marthoc/GarHAge/(threads)

Thread 2 (2017-08-29):

Upcoming Feature: Support for two garage door openers

marthoc, 2017-08-29:
Support will be added in the near future to control two garage door openers via one ESP8266 board.

marthoc, 2017-08-31:
Support has been added but code is currently untested; checkout the "two_doors" branch to test and please provide feedback.

marthoc, 2017-09-05:
Suppprt added in v1.0.0!

Closed 2017-09-05.

Thread 8 (2017-11-09):

Unable to publish to broker from other clients

bigalboyo, 2017-11-09:
Hi,
I've just setup and run this project but now only the ESP8266 can publish to the broker with its open or closed state.  Nothing else can publish anything else to the broker.  Even from the command line on the Pi running the broker, I can't publish anything.  Which also means I can't publish anything to trigger the relay.  Its like the program has taken complete control of the broker.  Any ideas why that might be?

Cheers

marthoc, 2017-11-09:
I can’t see how a client could possibly block other clients from connecting to or publishing to a broker. Can you give me more details about your setup (really just the broker and how it’s set up) so that I can try to replicate and help you debug?

One thing I’m wondering is if you have specified the same client ID on each device... that would create collisions and constant disconnects/reconnects from and to the broker by the late-joining client that could look like one client was dominating. Client IDs need to be unique.

bigalboyo, 2017-11-13:
Cheers for the response; I realise it is a long shot to put this code as the cause but everything stopped working the moment I ran it for the first time so logically, it got the blame.
As it happens, I ended up having to removed and reinstall mosquitto on the Pi to get the broker running properly again. I've now written my own version of this and everything is going fine. Will chalk it up to experience. cheers

marthoc, 2017-11-13:
Sorry to hear about your experience and that you couldn’t get GarHAge running. Thanks for reporting this, and if you have any more details so that I can examine the code please let me know.

Closed 2017-11-13.

Thread 10 (2017-12-13):

Feature request

harfordhawk, 2017-12-13:
I love this code and it works great, but I want to use it to attach nodemcu to existing wired alarm panel.  It works great for monitoring 2 'doors', and I really just want to be able to adjust code to use as many pins on the nodemcu as available and just get status messages from each, similar to the way it does now..
I am not so good at adjusting code to do that.. can you give me example code that just monitors those pins?  thanks so much

marthoc, 2017-12-14:
This would be easy to implement and in fact I’ve been thinking of releasing a new project that does exactly this - NodeMCU has 8 or 10 (I think) inputs that can be used for this, so could probably retrofit an existing alarm system with a few NodeMCUs pretty easily. Glad to know I’m not the only one that’s been thinking about it. If you give me a few days or so, I’ll get back to you with some code to test. Sound good?

marthoc, 2017-12-14:
Quick question - on your existing alarm system, do the wired sensors each have just two wires that connect to the existing controller?

harfordhawk, 2017-12-14:
thank you!  I hooked up to the door 1 and 2 with current code and it works
pretty well! Great way to retrofit old alarm system that we really don't
use!

On Thu, Dec 14, 2017 at 11:27 AM, Mark Coombes <notifications@github.com>
wrote:

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

harfordhawk, 2017-12-14:
well I am mostly interested in the simple door / window sensors so yeah,
just simple magnetic switches 2 wires,,  I ran a common from each to a
ground on board then one each to d5 and d6

On Thu, Dec 14, 2017 at 11:35 AM, Mark Coombes <notifications@github.com>
wrote:

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

harfordhawk, 2017-12-14:
by the way, I am trying to use it as a mqtt binary sensor... I am getting
some slow to no responses in that mode, but not sure if it's just me or what

On Thu, Dec 14, 2017 at 11:38 AM, mack goodman <mackgoodman@gmail.com>
wrote:

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

marthoc, 2017-12-14:
Hmm... you shouldn’t be getting “slow to no” responses; my experience is that the door state changes are reported virtually instantly. One way to start tracking down the cause is to connect the NodeMCU to your computer via USB (and thereby powering it over USB) and watching the serial monitor as you unplug one of the door sensor wires (simulating an open/close). The state change _should_ be instantly reported on the serial monitor. If you can run mosquitto_sub in a different window at the same time with this command:
`mosquitto_sub -h your.broker.ip.address -t "#" -v`
...you should see an MQTT message arrive at the broker instantly.

marthoc, 2017-12-14:
Maybe also post your configuration.yaml entry for the binary sensor (unless you’re just using what I suggest in README.md).

marthoc, 2017-12-15:
@harfordhawk I just added something for you to test: https://github.com/marthoc/EntrHAnce/releases. Please do and let me know how it goes! I've only verified that it compiles, but I haven't tested it at all yet myself. Please raise any issues on the EntrHAnce page, not here.

Closing this issue.

harfordhawk, 2017-12-15:
thanks! I will let you know when I test it out

On Fri, Dec 15, 2017 at 12:14 AM, Mark Coombes <notifications@github.com>
wrote:

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

harfordhawk, 2017-12-15:
been testing it and it loads fine .  I see the publishing on the serial
monitor
Acouple of things...

1. it seems that I need about 5 seconds between open and close to be
consistent. otherwise it sometimes does not toggle.

2. I can't find what the name of the topic is, at least it doesn't publish
in HA

here is my config

binary_sensor 2:
  - platform: mqtt
    name: "test Door"
    state_topic: "entry/1/status"

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

marthoc, 2017-12-15:
The info is in README.md of the dev branch, sorry. The topic is entry/pin# (so entry/1, etc.). You’ll also need to change the on and off payloads to open and closed.

harfordhawk, 2017-12-15:
okay, sorry I did not read that... seems to be working except the response
is sometimes incorrect when fast switching.  that may be just a function of
timing and asking too much from the mqtt ??  anyway thank you very much for
this code!

On Fri, Dec 15, 2017 at 9:37 AM, Mark Coombes <notifications@github.com>
wrote:

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

marthoc, 2017-12-15:
I think it’s related to the way I’m denouncing the switch inputs. I’ll test today and see if I can’t tweak it.

marthoc, 2017-12-15:
Also - what MQTT broker are you using? If it’s the embedded broker, you might want to test with mosquitto to rule that out.

harfordhawk, 2017-12-15:
i am running mosquitto on the Rpi.. seems to work fine for some other
sensors I have.

Just a thought.. maybe there is a way to put a redundancy in to check
status of pins?  I don't know anything about that but just thinking

On Fri, Dec 15, 2017 at 10:05 AM, Mark Coombes <notifications@github.com>
wrote:

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

harfordhawk, 2017-12-15:
i have noticed with the garage code that if the door is opening and shut
quickly it sometimes gets lost in the updates, then 30sec to a min later it
reports correctly, usually.

On Fri, Dec 15, 2017 at 10:08 AM, mack goodman <mackgoodman@gmail.com>
wrote:

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

marthoc, 2017-12-15:
I think it’s my debounce code. Essentially, when an input changes state (either high to low or vice versa, meaning a door has opened or closed), the code says, take that as the new state and don’t accept any new state changes for 2 seconds (given that reed switches are very bouncy, when they change state they may open and close several times). This prevents the broker from getting several open/closed/open/closed/open messages. So with the garage code, which I’ve reused here, if you open a door and then close it right away, it’s not going to pick that up until the debounce time has passed and the next time through the loop when the input is read again.

But it should be on the order of a few seconds delay in the HA frontend, not 30s to a minute.

As to redundancy, the inputs are supposed to be read on each loop through the code, which should be happening many many times per second. So if there’s a different state, the code should be picking that up very quickly and reporting the change.

I will investigate more and see if I can replicate this, and maybe change the debounce code since this is an issue that affects GarHAge as well.

harfordhawk, 2017-12-15:
could just be my HA code that is working too hard or not efficiently.. I
got a lot of stuff reporting! haha

On Fri, Dec 15, 2017 at 10:33 AM, Mark Coombes <notifications@github.com>
wrote:

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

marthoc, 2017-12-15:
That could be it, honestly. Code in HA runs asynchronous meaning it gets scheduled for execution, and the Pi only has so many resources...

marthoc, 2017-12-15:
OK so I had a chance to wire up my test unit. I'm not seeing any of the delays that you are with updating the state. Really the best way to check what part of your automation flow is responsible for the delay is to have the serial monitor open (and the NodeMCU connected to your computer via USB obviously), and also have a mosquitto_sub window open to watch for incoming messages at the broker.

When I change an input state (I've just wired the inputs to buttons I can push to pull the pin low), there's an instant message on the serial monitor and at the broker I'm watching via mosquitto_sub. So I think that your problem is either a faulty NodeMCU, some network latency, or latency introduced by running Home Assistant on the Raspberry Pi. My HA is set up on an Intel NUC so there's no concern about processing power there.

If you don't mind testing with the serial monitor and mosquitto_sub to help me verify that the latency is introduced outside of my code, I would appreciate it!

One snag I noticed is that D8 wasn't reacting properly; a bit of research revealed that you can't enable the internal pullup resistor on D8, so it can't be used for our purposes. That leaves 7 usable inputs per NodeMCU, which isn't bad - most existing alarm systems in sane-sided houses could probably be retrofitted with 2 or 3 NodeMCU's, I'd guess, which is still a pretty cheap way to do it.

Thanks for your help with this! Any other questions or comments please let me know.

harfordhawk, 2017-12-15:
I did what you said and it seems to be working properly... I think my lag
be associated with either overtaxed rpi or possibly flaky wifi in the area
where the nodemcu is... thanks for your code again!

On Fri, Dec 15, 2017 at 2:28 PM, Mark Coombes <notifications@github.com>
wrote:

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

bradcurtis, 2018-02-01:
Very cool,

I have the NodeMCU as well.  I updated the code to include a temperature/humidity and motion sensors.

Closed 2017-12-15.

Thread 11 (2018-01-27):

Can't compile in Arduino 1.8.5

mattie47, 2018-01-27:
When I try to compile for esp8266, I get:

```
exit status 1
invalid conversion from 'const char*' to 'const uint8_t* {aka const unsigned char*}' [-fpermissive]
```

config.h:
```
/*
 * GarHAge
 * a Home-Automation-friendly ESP8266-based MQTT Garage Door Controller
 * Licensed under the MIT License, Copyright (c) 2017 marthoc
 *
 * User-configurable Parameters
*/

// Wifi Parameters

#define WIFI_SSID "wifi ssid"
#define WIFI_PASSWORD "password"

// Static IP Parameters

#define STATIC_IP false
#define IP 192,168,1,100
#define GATEWAY 192,168,1,1
#define SUBNET 255,255,255,0

// MQTT Parameters

#define MQTT_BROKER "192.168.1.60"
#define MQTT_CLIENTID "GarHAge"
#define MQTT_USERNAME "asdf"
#define MQTT_PASSWORD "asdf"

// Relay Parameters

#define ACTIVE_HIGH_RELAY true

// Door 1 Parameters

#define DOOR1_ALIAS "Door 1"
#define MQTT_DOOR1_ACTION_TOPIC "garage/door/1/action"
#define MQTT_DOOR1_STATUS_TOPIC "garage/door/1/status"
#define DOOR1_OPEN_PIN D2
#define DOOR1_CLOSE_PIN D2
#define DOOR1_STATUS_PIN D5
#define DOOR1_STATUS_SWITCH_LOGIC "NO"

// Door 2 Parameters

#define DOOR2_ENABLED false
#define DOOR2_ALIAS "Door 2"
#define MQTT_DOOR2_ACTION_TOPIC "garage/door/2/action"
#define MQTT_DOOR2_STATUS_TOPIC "garage/door/2/status"
#define DOOR2_OPEN_PIN D1
#define DOOR2_CLOSE_PIN D1
#define DOOR2_STATUS_PIN D6
#define DOOR2_STATUS_SWITCH_LOGIC "NO"
```

Any idea on what I need to do to get this running? :-)

Kharte55, 2018-01-28:
Did you change anything but the config file e.g the firmware file

marthoc, 2018-01-28:
@mattie47 There must be more debug output that gets printed when the compile fails. I need to know which variable it’s complaining about.

mattie47, 2018-01-28:
@marthoc  I'll try again when I'm home from work re. more debug.

>I’m also assuming your wifi SSID doesn’t have a space in it in real life?

It does. I did wonder if this may cause a problem..

marthoc, 2018-01-28:
Well the easy way to test is to remove the space and try again to compile. If it works, there’s your problem. I have to double check but I don’t think the ESP8266WiFi library supports SSIDs with spaces.

marthoc, 2018-01-31:
Any update on this @mattie47? I’m planning a new release in the next week or so and if this is actually a bug I’d like to squash it before then.

walthowd, 2018-01-31:
FWIW, it compiles fine for me a with a space in the SSID. Arduino IDE 1.8.5, esp8266 2.4.0

marthoc, 2018-01-31:
I couldn’t replicate either, that’s why I’d like the full compile output.

mattie47, 2018-01-31:
Hey,

Sorry- life’s been busy. I’ll make it a priority today to try again this evening and post all relevant information.

Thanks,

Matt

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

mattie47, 2018-02-01:
Please see: https://pastebin.com/WJShtYNC

Removing the space in the ssid doesn't change the output.

marthoc, 2018-02-01:
Can you go into the Library Manager in Arduino IDE and tell me what version of PubSubClient you’re on? The call signatures and methods it’s complaining about are certainly in the version I developed against. Maybe you’re on an old version of PSC?

For an example, take one of the first problems it’s compaining of - that the code is trying to cast const char to const unsigned char in publish(); the current API docs clearly state that both topic and payload are const char and that retained is Boolean: https://pubsubclient.knolleary.net/api.html#publish2.

marthoc, 2018-02-01:
I just checked and I'm on PubSubClient 2.6, which according to GitHub is the latest release.

mattie47, 2018-02-01:
Ahhh - yes! This was my problem. I knew I had the PubSubClient installed, however having also had a look at https://github.com/OpenGarage/OpenGarage-Firmware I didn't realise the only version I had installed was https://github.com/Imroy/pubsubclient which was based on 1.99.1.

Having now also installed PubSubClient 2.6.0, GarHAge is now compiling :-)

Thanks!

marthoc, 2018-02-01:
Glad to hear it! Enjoy. :)

Closed 2018-02-01.

Thread 12 (2018-02-01):

OpenHab and publishing status

bradcurtis, 2018-02-01:
Hi,
I have your system working on openhab.  I was wondering what your thoughts were around not publishing status messages every minute or so.  Most of the other openhab implementations continuously publish the status of sensors.

I am using MQTT.fx.  I can see the status messages during open/close events, but I cannot see them running in a loop

Also, if you want I can write up what I did to get openhab working.  I had to translate some of your messages to work with the switch and contact items

garage/door/1/status
closed

void check_door1_status() {
  int currentStatusValue = digitalRead(door1_statusPin);
  if (currentStatusValue != door1_lastStatusValue) {
    unsigned int currentTime = millis();
    if (currentTime - door1_lastSwitchTime >= debounceTime) {
      publish_door1_status();
      door1_lastStatusValue = currentStatusValue;
      door1_lastSwitchTime = currentTime;
    }
  }
}

marthoc, 2018-02-01:
Yes it was a deliberate choice not to have the door status messages on a repeating loop because it’s not really necessary. The messages are published with the retain flag set, so any time your client (OpenHAB) connects to the broker it will get the latest status. If it’s not changing, then what’s the point of continually publishing it?

bradcurtis, 2018-02-01:
On Thu, Feb 1, 2018 at 4:40 PM Mark Coombes <notifications@github.com>
wrote:

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

The one thing I noticed is that my nodemcu is not transmitting the messages
all the time. It almost seems like it goes to sleep after long periods

I was just wondering if that was why tasmota and easy esp send status
updates every few minutes

marthoc, 2018-02-02:
Then I think there’s something wrong with your NodeMCU - maybe power supply issue? Or wireless dropping out? Because mine has been running GarHAge in my own garage for months now without a power cycle and it works every time. (That’s not a brag, btw, but it is a fact).

marthoc, 2018-02-02:
And all that being said, it’s trivial to add this feature so I will put it in the next update and make it a configurable option. Sound good?

bradcurtis, 2018-02-02:
Mark,

No worries, I was more curious on the pattern that some people use and why
they do it.

Thanks again for the hard work

<https://www.avast.com/sig-email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>
Virus-free.
www.avast.com
<https://www.avast.com/sig-email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>
<#DAB4FAD8-2DD7-40BB-A1B8-4E2AA1F9FDF2>

On Thu, Feb 1, 2018 at 6:17 PM, Mark Coombes <notifications@github.com>
wrote:

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

mrSabic, 2018-03-25:
Hi,
why does it sometimes publish the same message when i close and open the door status pin?

Door 2 open! Publishing to garage/door/2/status...
Door 2 open! Publishing to garage/door/2/status...

gusl79, 2018-10-08:
Hi Mark,

Just wondering if you would be able to share your Openhab setup with Garhage. I've managed to get Garhage working with MQTT.fx but can't seem to get Openahb to trigger my NodeMCU.

I presume it has to do with the translation you had to perform.

I'd be interested to see how you configured your items

Thread 16 (2018-03-25):

Publishing wrong message

mrSabic, 2018-03-25:
Hi,
why does it sometimes publish the same message when i close and open the door status pin?

Door 2 open! Publishing to garage/door/2/status...
Door 2 open! Publishing to garage/door/2/status...

marthoc, 2018-03-25:
I'll need a bit more detail from you. How can this be reproduced?

Since you're getting two "open" messages, my guess is that the way you've installed the door sensor the magnet isn't closed when it's in its resting position. When there's a state change (i.e. when the magnet passes close by to the reed switch as when the door is closing), GarHAge publishes a message immediately and then waits a short period before reading the status pin state again in order to debounce the circuit. I had a similar issue and the fix was to reposition the magnetic switch attached to the door.

mrSabic, 2018-03-25:
Sometimes i get two "closed" messages (serial monitor), i did not yet install the module, just testing it for now.
When i short and open the two door status pins (D5 and D6) with GND i sometimes get two same messages in serial monitor (open or closed), and the status in HA does not change...

P.S. sorry for my bad English.

marthoc, 2018-03-27:
This could be because GarHAge waits a short period after a status pin change before reading again as a debounce method. So if you’re just quickly grounding/opening the pin there’s a possibility that the delay would cause the same message to be published twice. I’m quite confident you wouldn’t see this behaviour in the real world though since the state wouldn’t be changing so quickly.

iceman73, 2018-04-05:
I had to adjust debounce to 3000 before mine stopped sending duplicate messages.

But I discovered your fixes branch and with the StatusSwitch Logic I was able to reduce debounce to 2500 and I no longer have multiple messages. (BTW I used Checkin Point https://github.com/marthoc/GarHAge/tree/1cf7e7e684b81ae500aca9d22a2f033bf3fcd5af, as thats the one with DHT support, nor broken auto discovery)

Chris

iceman73, 2018-04-05:
@marthoc BTW ArdrinoOTA is so nice when playing with values like this thankyou for adding it

marthoc, 2018-04-05:
@iceman73... I’m interested to hear you’re having this problem too. It’s been a while since I’ve had a chance to work on the dev branch (which will eventually turn into GarHAge 2.0) and even longer since master has been touched.

I’m still puzzled as to why the duplicate messages are happening. Reed switches are bouncy but they should be bouncy in the range of milliseconds, not seconds. The debounce value of 2000 was actually supposed to be way overkill for the purpose.

I’ll keep this issue open until I can put my finger on why it’s happening.

iceman73, 2018-04-05:
I think you Status may let me reduce debounce even more, could I assist in any debugs for you?

iceman73, 2018-04-06:
Ok SO I just Opened the Garage from a closed state and these are the MQTT Status:
```
garage/door/1/status closed
garage/door/1/action OPEN
garage/door/1/status open
garage/door/1/status closed
garage/door/1/status open
garage/door/1/status open
garage/door/1/status open
```
And when i close the Garage from MQTT:
```
garage/door/1/status open
garage/door/1/action CLOSE
garage/door/1/status closed
```

So looks like close is working but Open is weird

iceman73, 2018-04-06:
Spoke too soon, now I have the opposite:
```
garage/door/1/status closed
garage/door/1/action OPEN
garage/door/1/status open
garage/door/1/action CLOSE
garage/door/1/status open
garage/door/1/status open
garage/door/1/status closed
```

marthoc, 2018-04-06:
@iceman73 - are you using the new `dev` branch? It will be quite hard for me to debug unless I know you're on that branch since the code has changed somewhat through it's various iterations. At least if we're all on `dev` I know where we stand code-wise.

With respect to your most recent post that looks like this:
```
garage/door/1/status closed
garage/door/1/action OPEN
garage/door/1/status open
garage/door/1/action CLOSE
garage/door/1/status open
garage/door/1/status open
garage/door/1/status closed
```
Three questions:
1. Where is your reed switch mounted?
2. Is it normally open or normally closed?
3. Is the `#define DOOR1_STATUS_SWITCH_LOGIC` parameter set properly in config.h (`"NO"` if a normally open switch, "NC" if normally closed)?

Sorry for the basic questions but I'm trying to be thorough.

So we see that at first your door is closed, then you send an OPEN command, and the door opens, then the status gets updated to `open`. All is well so far.

Then you send a CLOSE command, and here's what I need to know about the open, open, closed sequence that follows: when do those messages get sent? As the door is closing, or just as it reaches the final resting position and the reed switch makes contact?

The strange part is that the code should ONLY be publishing a message when the door state pin changes states (from high to low if closing or low to high if opening, if using an NO switch). And when it does that, it should publish the opposite message (if the door is open, it should publish closed when the state changes). So I am having a hard time understanding why there are two open messages triggered.

If you can let me know that you're on the `dev` branch, and answer my above questions, then I'm going to have to take that and start going through the code function by function to see if there's an open statement somewhere that's provoking some errant messages.

Thanks for your help!

marthoc, 2018-04-06:
@iceman73 And another thing I just noticed from your two examples: does this repeated messaging only happen with "open"? The examples that you and @mrSabic posted all have duplicated `open` messages but `closed` seems ok. Makes me think more that there is an errant brace ( `{ `or` }` ) in the code somewhere that is syntactically correct (so the code compiles) but that is throwing off the logic.

marthoc, 2018-04-06:
Hmm. And just to clarify, does the right message end up being published? Or does it sometimes end up in a state where your physical door is closed but you aren’t getting a closed mqtt message?

iceman73, 2018-04-06:
The right final.messahe always makes it so home assistant always ends up right

mrSabic, 2018-04-07:
Hi,
tested it today, and no more duplicate messages

marthoc, 2018-04-07:
@iceman73 - given that in the end result the status is correct in Home Assistant, I'm not so worried about this issue. I believe I know why it's happening, and I can think of a couple of ways to solve it.

(What's happening now is: the loop function reads that the state is different than it was, then calls another function which _again_ reads the state and publishes an update based on _that_ state. So if your switch is particularly bouncy, there's a chance that the second read actually catches the state of the sensor when it's bounced and publishes based on that rather than the true state. It may happen again if the switch bounces more. Then, when the door has settled in its final location, the code works as its supposed to, reads the change of state, and publishes the correct state).

I'll think of the best way to patch this and let you know when there's a branch up for testing.

iceman73, 2018-04-08:
@marthoc appreciate your time let me know what I could do to help, I will look through that section of code as well and see if I could help in any changes.

marthoc, 2018-04-08:
Thanks! I was looking last night and know how I will patch. If you could test when it’s ready that would be great. Should have some time to do it in the next day or so.

marthoc, 2018-04-09:
@iceman73 - I've just pushed the `bugfix` branch to GitHub which is `dev` plus a potential fix for the double-message problem. This should solve at least one potential cause of the problem. If double-messages still happen, then the fix is to increase the "debounceTime" (to maybe 3000 or even 5000). debounceTime is actually probably misnamed, it should probably be called "deadTime" or something similar since it isn't actually trying to debounce the reed switch but just stop changes in the switch state from causing another MQTT publish until the door has settled in its final position. For a garage door opener, this amount of "dead time" seems perfectly fine, as in 99.9% of cases the door doesn't get immediately toggled open after closing or vice versa, and even in those cases it will be OK if 3 or 5 seconds elapse before the correct new state is transmitted, so 3 or 5 seconds after a state change seems fine to me for this parameter value.

iceman73, 2018-04-10:
Ok I will try this tomorrow and report back. Thankyiu again

iceman73, 2018-04-10:
@marthoc after setting Debounce to 3500, and using the bugfix branch, I now only get one message everytime.

Chris

mshoe007, 2019-05-22:
I think part of the issue with debouncing and things may be related to using 'unsigned int' instead of 'unsigned long' when working with millis();

See docs for millis() which say "Please note that the return value for millis() is of type unsigned long, logic errors may occur if a programmer tries to do arithmetic with smaller data types such as int. Even signed long may encounter errors as its maximum value is half that of its unsigned counterpart."

Line 205 and 217: "unsigned int currentTime = millis();"

The variable door1_lastSwitchTime is correctly declared "unsigned long", but storing the 'unsigned int currentTime' in it and then later doing math on it can fail:
  if (currentTime - door1_lastSwitchTime >= debounceTime)

On some platforms the number of bits in 'unsigned int' and 'unsigned long' is the same. This appears to be true on ESP8266, but it's still bad code to use 'unsigned int' to hold the result of 'millis()'

Closed 2019-10-28.

Thread 17 (2018-04-06):

HA - Error doing job: Task exception was never retrieved

littleperks, 2018-04-06:
First - Thank you for your work.  I am in the testing phases currently with Home Assistant (hass.io).  Things seem to be working but my home-assistant.log is filling up with this (about every 2 sec)...

```
2018-04-05 22:51:50 ERROR (MainThread) [homeassistant.core] Error doing job: Task exception was never retrieved
Traceback (most recent call last):
  File "/usr/lib/python3.6/site-packages/homeassistant/components/mqtt/__init__.py", line 594, in _async_perform_subscription
    _raise_on_error(result)
  File "/usr/lib/python3.6/site-packages/homeassistant/components/mqtt/__init__.py", line 680, in _raise_on_error
    'Error talking to MQTT: {}'.format(mqtt.error_string(result_code)))
homeassistant.exceptions.HomeAssistantError: Error talking to MQTT: The client is not currently connected.
```

After about 5-10min then GarHAge functionally stops and I have to cycle the NodeMCU which starts the process all over again.  I switched to your 'fixed' branch to see if that fixed it and also added/removed the automations.yaml configuration but no go.  I am using 'cover' method.

Have you seen this?  Any ideas you have would be appropriated.

Thanks again!

marthoc, 2018-04-06:
I haven't seen this particular error but I am very sure that it has nothing to do with GarHAge. No MQTT client should care whether another MQTT client is connected: Home Assistant connects to the broker and reads the topics and messages that get delivered to it regardless whether GarHAge is also connected to the broker.

What this looks like instead is that your Home Assistant instance is losing its own connection to your MQTT broker: the error is "Error talking to MQTT: The client is not currently connected." The _client_ that message is referring to is Home Assistant's MQTT client functionality. You'll need to troubleshoot what's going on with HA to cause this. Some things to consider to start:

1. What broker are you using? Is it HA's built-in broker, or a Hass.io add-on, or a separate server altogether?
2. If the broker is an add-on or separate server, what does your configuration.yaml `mqtt:` configuration look like?

Closed 2018-04-25.

Thread 20 (2018-04-26):

Incorporate limit switches into relay/motor code

danland6, 2018-04-26:
just wondering how hard it would be for you to modifiy the main ino code so that

essentially when you send the Open payload
- D2 keeps relay 1 HIGH, until NO limit switch on D5 goes LOW

and when sending closed Paylod

- D1 keeps relay 2 high, untill NO limit switch on D6 goes LOW (with option to maybe over run by a set amount of time,

Essentially i've built a gate that i am trying to automate for my chicken coup, using an old power window regulator/motor for lift, and a gravity latch that after all the tension is removed from the lift cable locks into a slot on one of the side rails, (which is why it would be good to have a slight overrun on close)

I have it all wired up on the bench with 2 relays (for motor reversal), and the 2 limit switches and have the buttons on my home assistant set up for testing, relay up, relay down, and status via one of the limits works fine as expected (i have used your code for my roller door, and front electric gate, and 2 side doors of my shed working great)

So far from all of my searching and lack of ardunio sketch skills i have not been able to figure out how to make these features work myself yet.

let me know if its something that you'd be keen to do, and if any of my information was not clear enough.

Thanks
Dan

danland6, 2018-04-28:
Hey Mark,
Thanks for the reply, yep makes sense that mostly everyone will not need
this feature for their garage doors!

Awesome that you are keen to help get it working, thanks already, also keen
to see what new features you've added to the existing setup.

And yes you've got it straight, i think the slight offset will be needed on
the close for sure, i will take a few pictures of my gate and post them up
somewhere, unless i can maybe mount one of the magnets to part of the
gravity locking mechanism so that it does not need to over run slightly,
which "may" be possible,

Thanks
Dan

danland6, 2018-04-28:
turns out its as easy as drag and drop, picture quality not amazing due to smashed lens on my phone camera but shows what i'm working with.

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

marthoc, 2018-04-30:
Quick question before I go too far: what microcontroller are you using? NodeMCU? Need to know how many GPIO I’m dealing with.

danland6, 2018-04-30:
Hey there, yep I'm Using the nodeMCU
Cheers
Dan

On Mon., 30 Apr. 2018, 10:46 pm Mark Coombes, <notifications@github.com>
wrote:

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

danland6, 2018-06-16:
Hey, i know its not high on your list but just checking in to see if you had any luck at all?
Cheers
Dan

PaulHam211, 2019-06-02:
This would be great, just what I am looking for too.

Thread 22 (2018-07-22):

Improvements: Wiring and OTA

codedmind, 2018-07-22:
I think is a plus having a wire schematic.
The d5 for the reed switch is missing in the building topic, the reed switch, in my case but assume for everyone should have a wire to gnd and that is missing to.

After all the code put in place and the nodemcd a good improvement is that the code allow OTA updates.

Last, thanks for your code, is working very good.

marthoc, 2018-07-23:
There are two sections in the instructions for wiring: one is "Building GarHAge", the other is "Installing GarHAge"; if you feel that these are incomplete feel free to suggest an improvement. I agree a wiring schematic would be helpful.

Re the OTA updates, check the `dev` branch. OTA and more are included.

HarrisrNZ, 2022-07-15:
Building GarHAge instructions are good. It is the integrating with home assistant that I am having issues with.

Closed 2018-07-23.

Thread 23 (2018-09-01):

Mqtt issue or code?

codedmind, 2018-09-01:
After some days working well now i'm getting issues when the garage doors is closed the homeassistant is getting wrong status inside a minute it open and close again, the garage door is always close...

If open everything is ok.

Any suggestion for debug?

marthoc, 2018-09-03:
Possible that your esp8266 device is dropping off the wifi network?

sam-wright, 2018-09-03:
Mine does the opposite of this (if open, it alternates between open and close every minute or so). This is because I didn't install a pull-down resistor, so then the door is open, that pin is left floating. Depending on your circuit, you may have left out a pull-up or a pull-down resistor.

codedmind, 2018-09-03:
When I test the first time with version 1 don't have issue only see that
after upload the vldev version.

But in none of the cases I use a pull up resistor :/

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

marthoc, 2018-09-03:
@sam-wright The pin shouldn’t be floating as I’m enabling the INPUT_PULLUP mode for the door status input pins. So when the door is closed, the pin is pulled low, but when open, the internal pull-up resistor should be pulling it high. Possible though that the resistor is too weak depending on your own environment. @codedmind you can try using a pull-up resistor and see if it solves your problem.

codedmind, 2018-09-04:
Any sechematics to use the pull-up?
Thanks

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

codedmind, 2018-09-15:
Ok i made the connections an try the both versions (master and dev) in the master the serial connections show normal output but the dev is always publish to mqtt don't now why... same connections , same hardware

`. WiFi connected - IP address: 192.168.1.80
Ready for OTA Upload...
Attempting MQTT connection...Connected!
Subscribing to GarHAge/api...
Publishing birth message "online" to GarHAge/availability...
Subscribing to garage/door/3/action...
Garage Door 3 open! Publishing to garage/door/3/status...
Attempting MQTT connection...Connected!
Subscribing to GarHAge/api...
Publishing birth message "online" to GarHAge/availability...
Subscribing to garage/door/3/action...
Garage Door 3 open! Publishing to garage/door/3/status...
Attempting MQTT connection...Connected!
Subscribing to GarHAge/api...
Publishing birth message "online" to GarHAge/availability...
Subscribing to garage/door/3/action...
Garage Door 3 open! Publishing to garage/door/3/status...
Attempting MQTT connection...Connected!
Subscribing to GarHAge/api...
Publishing birth message "online" to GarHAge/availability...
Subscribing to garage/door/3/action...
Garage Door 3 open! Publishing to garage/door/3/status...
Attempting MQTT connection...Connected!
Subscribing to GarHAge/api...
Publishing birth message "online" to GarHAge/availability...
Subscribing to garage/door/3/action...
Garage Door 3 open! Publishing to garage/door/3/status...
Attempting MQTT connection...Connected!
Subscribing to GarHAge/api...
Publishing birth message "online" to GarHAge/availability...
Subscribing to garage/door/3/action...
Garage Door 3 open! Publishing to garage/door/3/status...
Attempting MQTT connection...Connected!
Subscribing to GarHAge/api...
Publishing birth message "online" to GarHAge/availability...
Subscribing to garage/door/3/action...
Garage Door 3 open! Publishing to garage/door/3/status...
Attempting MQTT connection...Connected!
Subscribing to GarHAge/api...
Publishing birth message "online" to GarHAge/availability...
Subscribing to garage/door/3/action...
Garage Door 3 open! Publishing to garage/door/3/status...
Attempting MQTT connection...Connected!
Subscribing to GarHAge/api...
Publishing birth message "online" to GarHAge/availability...
Subscribing to garage/door/3/action...
Garage Door 3 open! Publishing to garage/door/3/status...
Attempting MQTT connection...Connected!
Subscribing to GarHAge/api...
Publishing birth message "online" to GarHAge/availability...
Subscribing to garage/door/3/action...
Garage Door 3 open! Publishing to garage/door/3/status...
Attempting MQTT connection...Connected!
Subscribing to GarHAge/api...
Publishing birth message "online" to GarHAge/availability...
Subscribing to garage/door/3/action...
Garage Door 3 open! Publishing to garage/door/3/status...
Attempting MQTT connection...Connected!
Subscribing to GarHAge/api...
Publishing birth message "online" to GarHAge/availability...
Subscribing to garage/door/3/action...
Garage Door 3 open! Publishing to garage/door/3/status...
Attempting MQTT connection...Connected!
Subscribing to GarHAge/api...
Publishing birth message "online" to GarHAge/availability...
Subscribing to garage/door/3/action...
Garage Door 3 open! Publishing to garage/door/3/status...
Attempting MQTT connection...Connected!
Subscribing to GarHAge/api...
Publishing birth message "online" to GarHAge/availability...
Subscribing to garage/door/3/action...
Garage Door 3 open! Publishing to garage/door/3/status...
Attempting MQTT connection...Connected!
Subscribing to GarHAge/api...
Publishing birth message "online" to GarHAge/availability...
Subscribing to garage/door/3/action...
Garage Door 3 open! Publishing to garage/door/3/status...
Attempting MQTT connection...Connected!
Subscribing to GarHAge/api...
Publishing birth message "online" to GarHAge/availability...
Subscribing to garage/door/3/action...
Garage Door 3 open! Publishing to garage/door/3/status...
Attempting MQTT connection...Connected!
Subscribing to GarHAge/api...
Publishing birth message "online" to GarHAge/availability...
Subscribing to garage/door/3/action...
Garage Door 3 open! Publishing to garage/door/3/status...
Attempting MQTT connection...Connected!
Subscribing to GarHAge/api...
Publishing birth message "online" to GarHAge/availability...
Subscribing to garage/door/3/action...
Garage Door 3 open! Publishing to garage/door/3/status...
Attempting MQTT connection...Connected!
Subscribing to GarHAge/api...
Publishing birth message "online" to GarHAge/availability...
Subscribing to garage/door/3/action...
Garage Door 3 open! Publishing to garage/door/3/status...
Attempting MQTT connection...Connected!
Subscribing to GarHAge/api...
Publishing birth message "online" to GarHAge/availability...
Subscribing to garage/door/3/action...
Garage Door 3 open! Publishing to garage/door/3/status...
Attempting MQTT connection...Connected!
Subscribing to GarHAge/api...
Publishing birth message "online" to GarHAge/availability...
Subscribing to garage/door/3/action...
Garage Door 3 open! Publishing to garage/door/3/status...
Attempting MQTT connection...Connected!
Subscribing to GarHAge/api...
Publishing birth message "online" to GarHAge/availability...
Subscribing to garage/door/3/action...
Garage Door 3 open! Publishing to garage/door/3/status...
Attempting MQTT connection...Connected!
Subscribing to GarHAge/api...
Publishing birth message "online" to GarHAge/availability...
Subscribing to garage/door/3/action...
Garage Door 3 open! Publishing to garage/door/3/status...
Attempting MQTT connection...Connected!
Subscribing to GarHAge/api...
Publishing birth message "online" to GarHAge/availability...
Subscribing to garage/door/3/action...
Garage Door 3 open! Publishing to garage/door/3/status...
Attempting MQTT connection...Connected!
Subscribing to GarHAge/api...
Publishing birth message "online" to GarHAge/availability...
Subscribing to garage/door/3/action...
Garage Door 3 open! Publishing to garage/door/3/status...
Attempting MQTT connection...Connected!
Subscribing to GarHAge/api...
Publishing birth message "online" to GarHAge/availability...
Subscribing to garage/door/3/action...
Garage Door 3 open! Publishing to garage/door/3/status...
Attempting MQTT connection...Connected!
Subscribing to GarHAge/api...
Publishing birth message "online" to GarHAge/availability...
Subscribing to garage/door/3/action...
Garage Door 3 open! Publishing to garage/door/3/status...
Attempting MQTT connection...Connected!
Subscribing to GarHAge/api...
Publishing birth message "online" to GarHAge/availability...
Subscribing to garage/door/3/action...
Garage Door 3 open! Publishing to garage/door/3/status...
Attempting MQTT connection...Connected!
Subscribing to GarHAge/api...
Publishing birth message "online" to GarHAge/availability...
Subscribing to garage/door/3/action...
Garage Door 3 open! Publishing to garage/door/3/status...
Attempting MQTT connection...Connected!
Subscribing to GarHAge/api...
Publishing birth message "online" to GarHAge/availability...
Subscribing to garage/door/3/action...
Garage Door 3 open! Publishing to garage/door/3/status...
Attempting MQTT connection...Connected!
Subscribing to GarHAge/api...
Publishing birth message "online" to GarHAge/availability...
Subscribing to garage/door/3/action...
Garage Door 3 open! Publishing to garage/door/3/status...
Attempting MQTT connection...Connected!
Subscribing to GarHAge/api...
Publishing birth message "online" to GarHAge/availability...
Subscribing to garage/door/3/action...
Garage Door 3 open! Publishing to garage/door/3/status...
Attempting MQTT connection...Connected!
Subscribing to GarHAge/api...
Publishing birth message "online" to GarHAge/availability...
Subscribing to garage/door/3/action...
Garage Door 3 open! Publishing to garage/door/3/status...
Attempting MQTT connection...Connected!
Subscribing to GarHAge/api...
Publishing birth message "online" to GarHAge/availability...
Subscribing to garage/door/3/action...
Garage Door 3 open! Publishing to garage/door/3/status...
Attempting MQTT connection...Connected!
Subscribing to GarHAge/api...
Publishing birth message "online" to GarHAge/availability...
Subscribing to garage/door/3/action...
Garage Door 3 open! Publishing to garage/door/3/status...
Attempting MQTT connection...Connected!
Subscribing to GarHAge/api...
Publishing birth message "online" to GarHAge/availability...
Subscribing to garage/door/3/action...
Garage Door 3 open! Publishing to garage/door/3/status...
Attempting MQTT connection...Connected!
Subscribing to GarHAge/api...
Publishing birth message "online" to GarHAge/availability...
Subscribing to garage/door/3/action...
Garage Door 3 open! Publishing to garage/door/3/status...
Attempting MQTT connection...Connected!
Subscribing to GarHAge/api...
Publishing birth message "online" to GarHAge/availability...
Subscribing to garage/door/3/action...
Garage Door 3 open! Publishing to garage/door/3/status...
Attempting MQTT connection...Connected!
Subscribing to GarHAge/api...
Publishing birth message "online" to GarHAge/availability...
Subscribing to garage/door/3/action...
Garage Door 3 open! Publishing to garage/door/3/status...
Attempting MQTT connection...Connected!
Subscribing to GarHAge/api...
Publishing birth message "online" to GarHAge/availability...
Subscribing to garage/door/3/action...
Garage Door 3 open! Publishing to garage/door/3/status...
Attempting MQTT connection...Connected!
Subscribing to GarHAge/api...
Publishing birth message "online" to GarHAge/availability...
Subscribing to garage/door/3/action...
Garage Door 3 open! Publishing to garage/door/3/status...
Attempting MQTT connection...Connected!
Subscribing to GarHAge/api...
Publishing birth message "online" to GarHAge/availability...
Subscribing to garage/door/3/action...
Garage Door 3 open! Publishing to garage/door/3/status...
Attempting MQTT connection...Connected!
Subscribing to GarHAge/api...
Publishing birth message "online" to GarHAge/availability...
Subscribing to garage/door/3/action...
Garage Door 3 open! Publishing to garage/door/3/status...
Attempting MQTT connection...Connected!
Subscribing to GarHAge/api...
Publishing birth message "online" to GarHAge/availability...
Subscribing to garage/door/3/action...
Garage Door 3 open! Publishing to garage/door/3/status...
Attempting MQTT connection...Connected!
Subscribing to GarHAge/api...
Publishing birth message "online" to GarHAge/availability...
Subscribing to garage/door/3/action...
Garage Door 3 open! Publishing to garage/door/3/status...
Attempting MQTT connection...Connected!
Subscribing to GarHAge/api...
Publishing birth message "online" to GarHAge/availability...
Subscribing to garage/door/3/action...
Garage Door 3 open! Publishing to garage/door/3/status...
Attempting MQTT connection...Connected!
Subscribing to GarHAge/api...
Publishing birth message "online" to GarHAge/availability...
Subscribing to garage/door/3/action...
Garage Door 3 open! Publishing to garage/door/3/status...
Attempting MQTT connection...Connected!
Subscribing to GarHAge/api...
Publishing birth message "online" to GarHAge/availability...
Subscribing to garage/door/3/action...
Garage Door 3 open! Publishing to garage/door/3/status...
Attempting MQTT connection...Connected!
Subscribing to GarHAge/api...
Publishing birth message "online" to GarHAge/availability...
Subscribing to garage/door/3/action...
Garage Door 3 open! Publishing to garage/door/3/status...
Attempting MQTT connection...Connected!
Subscribing to GarHAge/api...
Publishing birth message "online" to GarHAge/availability...
Subscribing to garage/door/3/action...
Garage Door 3 open! Publishing to garage/door/3/status...
Attempting MQTT connection...Connected!
Subscribing to GarHAge/api...
Publishing birth message "online" to GarHAge/availability...
Subscribing to garage/door/3/action...
Garage Door 3 open! Publishing to garage/door/3/status...
Attempting MQTT connection...Connected!
Subscribing to GarHAge/api...
Publishing birth message "online" to GarHAge/availability...
Subscribing to garage/door/3/action...
Garage Door 3 open! Publishing to garage/door/3/status...
Attempting MQTT connection...Connected!
Subscribing to GarHAge/api...
Publishing birth message "online" to GarHAge/availability...
Subscribing to garage/door/3/action...
Garage Door 3 open! Publishing to garage/door/3/status...
Attempting MQTT connection...Connected!
Subscribing to GarHAge/api...
Publishing birth message "online" to GarHAge/availability...
Subscribing to garage/door/3/action...
Garage Door 3 open! Publishing to garage/door/3/status...
Attempting MQTT connection...Connected!
Subscribing to GarHAge/api...
Publishing birth message "online" to GarHAge/availability...
Subscribing to garage/door/3/action...
Garage Door 3 open! Publishing to garage/door/3/status...
Attempting MQTT connection...Connected!
Subscribing to GarHAge/api...
Publishing birth message "online" to GarHAge/availability...
Subscribing to garage/door/3/action...
Garage Door 3 open! Publishing to garage/door/3/status...
Attempting MQTT connection...Connected!
Subscribing to GarHAge/api...
Publishing birth message "online" to GarHAge/availability...
Subscribing to garage/door/3/action...
Garage Door 3 open! Publishing to garage/door/3/status...
Attempting MQTT connection...Connected!
Subscribing to GarHAge/api...
Publishing birth message "online" to GarHAge/availability...
Subscribing to garage/door/3/action...
Garage Door 3 open! Publishing to garage/door/3/status...
Attempting MQTT connection...Connected!
Subscribing to GarHAge/api...
Publishing birth message "online" to GarHAge/availability...
Subscribing to garage/door/3/action...
Garage Door 3 open! Publishing to garage/door/3/status...
Attempting MQTT connection...Connected!
Subscribing to GarHAge/api...
Publishing birth message "online" to GarHAge/availability...
Subscribing to garage/door/3/action...
Garage Door 3 open! Publishing to garage/door/3/status...
Attempting MQTT connection...Connected!
Subscribing to GarHAge/api...
Publishing birth message "online" to GarHAge/availability...
Subscribing to garage/door/3/action...
Garage Door 3 open! Publishing to garage/door/3/status...
Attempting MQTT connection...Connected!
Subscribing to GarHAge/api...
Publishing birth message "online" to GarHAge/availability...
Subscribing to garage/door/3/action...
Garage Door 3 open! Publishing to garage/door/3/status...
Attempting MQTT connection...Connected!
Subscribing to GarHAge/api...
Publishing birth message "online" to GarHAge/availability...
Subscribing to garage/door/3/action...
Garage Door 3 open! Publishing to garage/door/3/status...
Attempting MQTT connection...Connected!
Subscribing to GarHAge/api...
Publishing birth message "online" to GarHAge/availability...
Subscribing to garage/door/3/action...
Garage Door 3 open! Publishing to garage/door/3/status...
Attempting MQTT connection...Connected!
Subscribing to GarHAge/api...
Publishing birth message "online" to GarHAge/availability...
Subscribing to garage/door/3/action...
Garage Door 3 open! Publishing to garage/door/3/status...
Attempting MQTT connection...Connected!
Subscribing to GarHAge/api...
Publishing birth message "online" to GarHAge/availability...
Subscribing to garage/door/3/action...
Garage Door 3 open! Publishing to garage/door/3/status...
Attempting MQTT connection...Connected!
Subscribing to GarHAge/api...
Publishing birth message "online" to GarHAge/availability...
Subscribing to garage/door/3/action...
Garage Door 3 open! Publishing to garage/door/3/status...
Attempting MQTT connection...Connected!
Subscribing to GarHAge/api...
Publishing birth message "online" to GarHAge/availability...
Subscribing to garage/door/3/action...
Garage Door 3 open! Publishing to garage/door/3/status...
Attempting MQTT connection...Connected!
Subscribing to GarHAge/api...
Publishing birth message "online" to GarHAge/availability...
Subscribing to garage/door/3/action...
Garage Door 3 open! Publishing to garage/door/3/status...
Attempting MQTT connection...Connected!
Subscribing to GarHAge/api...
Publishing birth message "online" to GarHAge/availability...
Subscribing to garage/door/3/action...
Garage Door 3 open! Publishing to garage/door/3/status...
Attempting MQTT connection...Connected!
Subscribing to GarHAge/api...
Publishing birth message "online" to GarHAge/availability...
Subscribing to garage/door/3/action...
Garage Door 3 open! Publishing to garage/door/3/status...
Attempting MQTT connection...Connected!
Subscribing to GarHAge/api...
Publishing birth message "online" to GarHAge/availability...
Subscribing to garage/door/3/action...
Garage Door 3 open! Publishing to garage/door/3/status...
Attempting MQTT connection...Connected!
Subscribing to GarHAge/api...
Publishing birth message "online" to GarHAge/availability...
Subscribing to garage/door/3/action...
Garage Door 3 open! Publishing to garage/door/3/status...
Attempting MQTT connection...Connected!
Subscribing to GarHAge/api...
Publishing birth message "online" to GarHAge/availability...
Subscribing to garage/door/3/action...
Garage Door 3 open! Publishing to garage/door/3/status...
Attempting MQTT connection...Connected!
Subscribing to GarHAge/api...
Publishing birth message "online" to GarHAge/availability...
Subscribing to garage/door/3/action...
Garage Door 3 open! Publishing to garage/door/3/status...
Attempting MQTT connection...Connected!
Subscribing to GarHAge/api...
Publishing birth message "online" to GarHAge/availability...
Subscribing to garage/door/3/action...
Garage Door 3 open! Publishing to garage/door/3/status...
Attempting MQTT connection...Connected!
Subscribing to GarHAge/api...
Publishing birth message "online" to GarHAge/availability...
Subscribing to garage/door/3/action...
Garage Door 3 open! Publishing to garage/door/3/status...
Attempting MQTT connection...Connected!
Subscribing to GarHAge/api...
Publishing birth message "online" to GarHAge/availability...
Subscribing to garage/door/3/action...
Garage Door 3 open! Publishing to garage/door/3/status...
Attempting MQTT connection...Connected!
Subscribing to GarHAge/api...
Publishing birth message "online" to GarHAge/availability...
Subscribing to garage/door/3/action...
Garage Door 3 closed! Publishing to garage/door/3/status...
Garage Door 3 closed! Publishing to garage/door/3/status...
Attempting MQTT connection...Connected!
Subscribing to GarHAge/api...
Publishing birth message "online" to GarHAge/availability...
Subscribing to garage/door/3/action...
Garage Door 3 closed! Publishing to garage/door/3/status...
Attempting MQTT connection...Connected!
Subscribing to GarHAge/api...
Publishing birth message "online" to GarHAge/availability...
Subscribing to garage/door/3/action...
Garage Door 3 closed! Publishing to garage/door/3/status...
Attempting MQTT connection...Connected!
Subscribing to GarHAge/api...
Publishing birth message "online" to GarHAge/availability...
Subscribing to garage/door/3/action...
Garage Door 3 closed! Publishing to garage/door/3/status...
Attempting MQTT connection...Connected!
Subscribing to GarHAge/api...
Publishing birth message "online" to GarHAge/availability...
Subscribing to garage/door/3/action...
Garage Door 3 closed! Publishing to garage/door/3/status...
Attempting MQTT connection...Connected!
Subscribing to GarHAge/api...
Publishing birth message "online" to GarHAge/availability...
Subscribing to garage/door/3/action...
Garage Door 3 closed! Publishing to garage/door/3/status...
Attempting MQTT connection...Connected!
Subscribing to GarHAge/api...
Publishing birth message "online" to GarHAge/availability...
Subscribing to garage/door/3/action...
Garage Door 3 closed! Publishing to garage/door/3/status...
Attempting MQTT connection...Connected!
Subscribing to GarHAge/api...
Publishing birth message "online" to GarHAge/availability...
Subscribing to garage/door/3/action...
Garage Door 3 closed! Publishing to garage/door/3/status...
Attempting MQTT connection...Connected!
Subscribing to GarHAge/api...
Publishing birth message "online" to GarHAge/availability...
Subscribing to garage/door/3/action...
Garage Door 3 closed! Publishing to garage/door/3/status...
Attempting MQTT connection...Connected!
Subscribing to GarHAge/api...
Publishing birth message "online" to GarHAge/availability...
Subscribing to garage/door/3/action...
Garage Door 3 closed! Publishing to garage/door/3/status...
Attempting MQTT connection...Connected!
Subscribing to GarHAge/api...
Publishing birth message "online" to GarHAge/availability...
Subscribing to garage/door/3/action...
Garage Door 3 closed! Publishing to garage/door/3/status...
Attempting MQTT connection...Connected!
Subscribing to GarHAge/api...
Publishing birth message "online" to GarHAge/availability...
Subscribing to garage/door/3/action...
Garage Door 3 closed! Publishing to garage/door/3/status...
Attempting MQTT connection...Connected!
Subscribing to GarHAge/api...
Publishing birth message "online" to GarHAge/availability...
Subscribing to garage/door/3/action...
Garage Door 3 closed! Publishing to garage/door/3/status...
Attempting MQTT connection...Connected!
Subscribing to GarHAge/api...
Publishing birth message "online" to GarHAge/availability...
Subscribing to garage/door/3/action...
Garage Door 3 closed! Publishing to garage/door/3/status...
Attempting MQTT connection...Connected!
Subscribing to GarHAge/api...
Publishing birth message "online" to GarHAge/availability...
Subscribing to garage/door/3/action...
Garage Door 3 closed! Publishing to garage/door/3/status...
Attempting MQTT connection...Connected!
Subscribing to GarHAge/api...
Publishing birth message "online" to GarHAge/availability...
Subscribing to garage/door/3/action...
Garage Door 3 closed! Publishing to garage/door/3/status...
Attempting MQTT connection...Connected!
Subscribing to GarHAge/api...
Publishing birth message "online" to GarHAge/availability...
Subscribing to garage/door/3/action...
Garage Door 3 closed! Publishing to garage/door/3/status...
Attempting MQTT connection...Connected!
Subscribing to GarHAge/api...
Publishing birth message "online" to GarHAge/availability...
Subscribing to garage/door/3/action...
Garage Door 3 closed! Publishing to garage/door/3/status...
Attempting MQTT connection...Connected!
Subscribing to GarHAge/api...
Publishing birth message "online" to GarHAge/availability...
Subscribing to garage/door/3/action...
Garage Door 3 closed! Publishing to garage/door/3/status...
Attempting MQTT connection...Connected!
Subscribing to GarHAge/api...
Publishing birth message "online" to GarHAge/availability...
Subscribing to garage/door/3/action...
Garage Door 3 closed! Publishing to garage/door/3/status...
Attempting MQTT connection...Connected!
Subscribing to GarHAge/api...
Publishing birth message "online" to GarHAge/availability...
Subscribing to garage/door/3/action...
Garage Door 3 closed! Publishing to garage/door/3/status...
Attempting MQTT connection...Connected!
Subscribing to GarHAge/api...
Publishing birth message "online" to GarHAge/availability...
Subscribing to garage/door/3/action...
Garage Door 3 closed! Publishing to garage/door/3/status...
Attempting MQTT connection...Connected!
Subscribing to GarHAge/api...
Publishing birth message "online" to GarHAge/availability...
Subscribing to garage/door/3/action...
Garage Door 3 closed! Publishing to garage/door/3/status...
Attempting MQTT connection...Connected!
Subscribing to GarHAge/api...
Publishing birth message "online" to GarHAge/availability...
Subscribing to garage/door/3/action...
Garage Door 3 closed! Publishing to garage/door/3/status...
Attempting MQTT connection...Connected!
Subscribing to GarHAge/api...
Publishing birth message "online" to GarHAge/availability...
Subscribing to garage/door/3/action...
Garage Door 3 closed! Publishing to garage/door/3/status...
Attempting MQTT connection...Connected!
Subscribing to GarHAge/api...
Publishing birth message "online" to GarHAge/availability...
Subscribing to garage/door/3/action...
Garage Door 3 closed! Publishing to garage/door/3/status...
Attempting MQTT connection...Connected!
Subscribing to GarHAge/api...
Publishing birth message "online" to GarHAge/availability...
Subscribing to garage/door/3/action...
Garage Door 3 closed! Publishing to garage/door/3/status...
Attempting MQTT connection...Connected!
Subscribing to GarHAge/api...
Publishing birth message "online" to GarHAge/availability...
Subscribing to garage/door/3/action...
Garage Door 3 closed! Publishing to garage/door/3/status...
Attempting MQTT connection...Connected!
Subscribing to GarHAge/api...
Publishing birth message "online" to GarHAge/availability...
Subscribing to garage/door/3/action...
Garage Door 3 closed! Publishing to garage/door/3/status...
Attempting MQTT connection...Connected!
Subscribing to GarHAge/api...
Publishing birth message "online" to GarHAge/availability...
Subscribing to garage/door/3/action...
Garage Door 3 closed! Publishing to garage/door/3/status...
Attempting MQTT connection...Connected!
Subscribing to GarHAge/api...
Publishing birth message "online" to GarHAge/availability...
Subscribing to garage/door/3/action...
Garage Door 3 closed! Publishing to garage/door/3/status...
Attempting MQTT connection...Connected!
Subscribing to GarHAge/api...
Publishing birth message "online" to GarHAge/availability...
Subscribing to garage/door/3/action...
Garage Door 3 closed! Publishing to garage/door/3/status...
Attempting MQTT connection...Connected!
Subscribing to GarHAge/api...
Publishing birth message "online" to GarHAge/availability...
Subscribing to garage/door/3/action...
Garage Door 3 closed! Publishing to garage/door/3/status...
Attempting MQTT connection...Connected!
Subscribing to GarHAge/api...
Publishing birth message "online" to GarHAge/availability...
Subscribing to garage/door/3/action...
Garage Door 3 closed! Publishing to garage/door/3/status...
Attempting MQTT connection...Connected!
Subscribing to GarHAge/api...
Publishing birth message "online" to GarHAge/availability...
Subscribing to garage/door/3/action...
Garage Door 3 closed! Publishing to garage/door/3/status...
Attempting MQTT connection...Connected!
Subscribing to GarHAge/api...
Publishing birth message "online" to GarHAge/availability...
Subscribing to garage/door/3/action...
Garage Door 3 closed! Publishing to garage/door/3/status...
Attempting MQTT connection...Connected!
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

Thread 25 (2018-09-22):

ArduinoJSON

rumlak, 2018-09-22:
Update to use latest ArduinoJSON version. (or at least update instructions to specify)

Anything after 5.13.2 does not support jsonBuffer and throws errors.

marthoc, 2018-10-02:
From the ArduinoJSON site: “The Arduino Library Manager installs the ArduinoJson version 6 by default.
However, using version 5 is highly recommended because version 6 is still in beta stage. Open the Arduino Library Manager and make sure that ArduinoJson version 5 is installed.”

Thread 26 (2018-09-30):

Continual Status MQTT Commands

benmprojects, 2018-09-30:
Hi,

I have just hooked up my reed switch and it is reporting the state correctly but I receive continual garage/door/1/status reports 1 or 2 every second. Looking at the code this should not happen as the CurrentState is the same as PreviousState.

Any ideas?

Thanks Ben

marthoc, 2018-10-01:
Can you try the dev branch? There have been some updates which may address. Otherwise you may need to add a pull-up resistor on the input pin to hold it high, it sounds like it could be floating. Not all esp8266 hardware packages are made equal unfortunately and it could be that the pull-ups in whatever version you have just aren’t doing it.

Thread 27 (2018-10-09):

Is there way I could replace Z Wave tilt sensor on garage door instead of using magnetic sensors?

slonkar, 2018-10-09:
I already have Z wave sensor mounted on my garage door. If I am not wrong, you are using magnetic sensors to basically broadcast the state of the door. Is there way I could tweak your code in-order to support Z Wave + relay configuration instead of magnetic switch + relay configuration?

walthowd, 2018-10-09:
Assuming you are using Home Assistant?

I use Z wave sensors and just have the cover set to optimistic and it works fine.

```
- platform: mqtt
  name: "Garage Door North"
  state_topic: "garage/door/north/status"
  command_topic: "garage/door/north/action"
  availability_topic: "GarHAge/availability"
  optimistic: true
  qos: 0
  retain: false
  payload_open: "OPEN"
  payload_close: "CLOSE"
  payload_stop: "STATE"
  state_open: "open"
  state_closed: "closed"
  payload_available: "online"
  payload_not_available: "offline"
```

Then I have a template switch that I use to mainly control the door, that reports the status via the Z wave sensor:

```
- platform: template
  switches:
    garage_door_north:
      value_template: "{{ is_state('sensor.garage_door_north_tilt_alarm_level', '255') }}"
      turn_on:
        service: cover.open_cover
        data:
          entity_id: cover.garage_door_north
      turn_off:
        service: cover.close_cover
        data:
          entity_id: cover.garage_door_north
      icon_template: >-
        {% if is_state('sensor.garage_door_north_tilt_alarm_level', '255') %}
          mdi:garage-open
        {% else %}
          mdi:garage
        {% endif %}
```

Finally, I also have some Node-RED flows that read the state of the sensors and inject the MQTT messages to keep the state topics on the garage door cover in sync. Not needed in my setup, but just to have everything reporting the same across the board.

marthoc, 2018-10-16:
@slonkar - you can use the template cover component of HA to do this. Essentially what @walthowd showed you except instead of a switch you get a cover device at the end. Useful if you’re using the HomeKit component so that it shows as a Garage Door, for instance. Let me know if you need better instructions...

shoeman22, 2018-12-16:
Just wanted to comment and say that this cover approach worked perfect for me using an [Ecolink
Z-Wave Plus Tilt Sensor](https://www.amazon.com/Ecolink-Intelligent-Technology-Z-Wave-TILT-ZWAVE2-ECO/dp/B01MRZB0NT?th=1).

Based on how I did my binary sensors, I had to check for "on" instead of "open".  Here's the relevant config for me.  `binary_sensor.main_bay_garage_door_tilt_binary_sensor` is created automatically by the tilt switch when HA brings it it.  I could probably just use it but I like making explicity binary_sensors so I can use them should I ever decided.

Here's my final config for reference (note I also changed in config.h the mqtt topic)
```
binary_sensor:
  - platform: template
    sensors:
      is_main_bay_garage_door_open:
        value_template: '{% if is_state("binary_sensor.main_bay_garage_door_tilt_binary_sensor", "off") %}false{% else %}true{% endif %}'
        device_class: garage_door
        friendly_name: 'Main Bay Garage Door (tilt)'
        entity_id: binary_sensor.main_bay_garage_door_tilt_binary_sensor

cover:
  - platform: template
    covers:
      main_bay_garage_door:
        friendly_name: "Main Bay Garage Door"
        value_template: "{{ is_state('binary_sensor.is_main_bay_garage_door_open', 'on') }}"
        entity_id: binary_sensor.is_main_bay_garage_door_open
        open_cover:
          service: mqtt.publish
          data:
            topic: garage/main_bay/action
            payload: OPEN
        close_cover:
          service: mqtt.publish
          data:
            topic: garage/main_bay/action
            payload: CLOSE
```

Also, thank you very much @marthoc for garHAge in general.  This is the first time I've ever really mucked around with DIY on a project like this and your instructions and bill of materials were absolutely top notch.

Thread 28 (2018-11-09):

Relay fires when power is applied

harfordhawk, 2018-11-09:
Mark,
I am trying to use this code very simply with a nodemcu and a 4-relay board.  I power the relay from a separate 5V line from the same usb power source.  Have common grounds between them.  Anyway, everything works great except the power up sequence, which fires the relay. This is not good as you know for when I have a power outage, the garage will open when power is restored.
I have tried setting active high and active low.  Do you have any ideas how I can stop the triggering on power up?  Thanks

Mike1082, 2018-11-12:
I think this has something to do with certain pins on the NodeMCU being pulled high or low during boot. I am running into this exact issue myself with a NodeMCU and 2 relay module while automating my doorbell (essentially the same thing as this project). Are you using D0 (GPIO 16)? [See here for more information](https://github.com/thehookup/Wireless_MQTT_Doorbell/blob/master/GPIO_Limitations_ESP8266_NodeMCU.jpg).

harfordhawk, 2018-11-12:
have not tried D0, but tried many of the other 'safe' pins, and it still
fires on power up.  Ofcourse , we can't have that for a garage door as if
we lose power, say while we are away, the garage door would open

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

--
"Go serve your King"  https://www.wretched.org/dontstubyourtoe/

Mike1082, 2018-11-13:
Ok I was just able to get around this on my doorbell sketch. I don't know if this is a preferred method, or if there is a better way, but my relays are no longer firing on bootup (using D0 and D2 on NodeMCU). I did a digitalWrite to HIGH before setting the pinMode in the void setup() function. I found the solution [here](https://electronics.stackexchange.com/questions/231742/how-to-enable-output-pin-to-high-by-default-in-arduino-uno).

```
digitalWrite (RELAY1, HIGH);
digitalWrite (RELAY2, HIGH;
pinMode (RELAY1, OUTPUT);
pinMode (RELAY2, OUTPUT);
```

If this is bad, and someone knows a better way, please let me know.

Thread 31 (2019-02-02):

Wrong 5V power supply link in the readme

chartrand22, 2019-02-02:
The readme points to the wrong 5V power supply.  It's pointing to  RB-Spa-108 which is NOT micro USB.

Thread 32 (2019-02-10):

Preventing Multiple Triggers

aditsachde, 2019-02-10:
If I click open in home assistant, and then hit open again when the garage is opening, the garage stalls because another open signal has been sent to it. What would be the best way to ignore a second trigger within a 15 or so second period after the first trigger? There is no clean way to do this in home assistant and doing it within GarHAge would be more platform agnostic.

I'm not sure if this solution is optimal, but one method would be setting a variable when the door is triggered. A loop can detect a change and then reset it after 15 seconds. When triggering the door, this variable can be checked to make sure it is in the default state. Essentially, after triggering the door once, disabling any subsequent triggers for 15 seconds.

heymoe, 2019-02-14:
I would think multiple triggers would be the expected behavior for a garage door. If you locked out the buttons for 15 seconds then there would be no way to stop the door in any position other than fully open or fully closed.

That being said, I could see you wrapping the call to the triggerDoorAction function inside the callback function with the same if logic that is used the the check_door#_status function (debounce) that prevents false activation readings of the reed switch while the door is moving.

Like So:
```
  unsigned int currentTime = millis();
  if (currentTime - lastClickTime >= lockOutTime) {
    triggerDoorAction(topicToProcess, payloadToProcess);
    lastClickTime = currentTime;
  }
```
You will need to define the lastClickTime and lockOutTime vars as a global just like door1_lastSwitchTime.

```
unsigned long lastClickTime = 0;
int lockOutTime = 15;
```
Defining lockOutTime = 0 would maintain the current behavior of allowing multiple clicks.

DenseComet, 2019-02-14:
I'll try this out when I get a chance thanks!

I would like to make sure that the door is not in any state but fully open or fully closed. This is because I have no way to detect if it is in an in between state. If it gets stuck in an in between state, home assistant would still show that it is closed. If it can be in an in between position, I can never have a guarantee that it is completely closed.

heymoe, 2019-02-14:
Ahhh, I worked around your in between state by having it so that when the reed switch is activated (closed) that means my garage door is fully closed instead of it meaning fully open.

marthoc, 2019-02-16:
@DenseComet - you should install the reed switch so that the magnets are close together when the door is completely closed. That way, any other position will cause Home Assistant to report the door as open.

aditsachde, 2019-06-08:
@heymoe's solution worked perfectly. Obviously putting the reed switch in a better location would be optimal, but for my usecase, it works perfectly.

https://github.com/aditsachde/GarHAge/blob/master/GarHAge/GarHAge.ino#L105

Closed 2019-06-08.

Thread 33 (2019-10-28):

action triggered on connection to relay

ehudkaldor, 2019-10-28:
not sure if this is something you can help with, but here goes:

as soon as i connect the relay to the garage door trigger (COM and NO), it triggers an action. at this point, i can control the garage door via MQTT, but the physical button stops working. i am not sure if i'm connecting something wrong, but this happens even if the relay is not corrected to power. and i've tried it with 2 different relays.

help. please.

mrSabic, 2019-10-28:
Strange, normally this would happen if you connect the wires to COM and NC, maybe the relay is broken. Test it with a multimeter, there shouldn't be continuity between COM and NO (when the relay is not powered).

cmcapone, 2020-05-31:
I had this same issue.  My relay was active-low (which I didn't realize) and I hadn't set ACTIVE_HIGH_RELAY to false.  I updated the .h, uploaded the new sketch and it worked perfectly (physical buttons work again).

cben0ist, 2021-05-03:
> I had this same issue. My relay was active-low (which I didn't realize) and I hadn't set ACTIVE_HIGH_RELAY to false. I updated the .h, uploaded the new sketch and it worked perfectly (physical buttons work again).

That just saved my day. I was in the same case using an ESP-01/01S
And here is how to set ACTIVE_HIGH_RELAY to false in ESPHome: https://esphome.io/components/switch/gpio.html#active-low-switch

Thank you!

Thread 34 (2019-12-30):

Garage periodically appears as unavailable in HA

nadnerb33, 2019-12-30:
I've set up a ESP8266 with a reed switch to simply monitor the status of the garage door (but not control it).
It seems to work well and the status in HA is responsive when I open/close the garage door.
The problem is several times per hour it shows the status as "unavailable" for what I assume only a split second before providing a "closed" status again. During this time the door is closed and power supply is fine. The constant switching between "unavailable" and "closed" just clogs up the HA logs and makes it look like the garage was recently open even if it's been shut for hours.

Things I've tried:
- different USB power supplies plugged into mains
- USB battery pack
- placing device right next to wifi router
- upgraded my Arduino board manager for esp8266 from 2.4 to 2.6.3
- added `#define MQTT_KEEPALIVE 10` to match mosquitto keepalive

So I don't think it is an issue with wifi signal or power.
In the Mosquitto log I see:

```
1577719913: Socket error on client GarHAge, disconnecting.
1577719914: New connection from 192.168.0.153 on port 1883.
1577719914: New client connected from 192.168.0.153 as GarHAge (c1, k15, u'').
1577720530: Socket error on client GarHAge, disconnecting.
1577720530: New connection from 192.168.0.153 on port 1883.
1577720530: New client connected from 192.168.0.153 as GarHAge (c1, k15, u'').
```
It often disconnects and reconnects within a second so am wondering if the `keepalive` values in the client or broker need to be adjusted?

Thanks

cmcapone, 2020-07-03:
Curious if you ever found a solution? I'm having the same issue and confirmed that the actual device has stayed connected to my router for ~100 hours.
Note that occasionally I see a longer delay in addition to the "instant" disconnect/reconnects - strangely almost always in the 14-16 minute range.

rumlak, 2020-07-03:
I am running the dev version and have never had a problem.  Been running for a couple of years with zero intervention.

cmcapone, 2020-07-03:
Interesting, I was simply running the "master" branch.  I will try the dev version - a bit painful to go and retrieve the device, but it looks like the dev version has OTA updates (master does not).  It is worth a try, thank you - I'll report back if there are any results.

nadnerb33, 2020-07-06:
I don't think I ever found a proper solution/cause of the problem.

After testing various things I decided to just leave it as is and wire it all up in the garage.
I think I made a tweak in Home Assistant so it didn't show the millisecond `unavailable` statuses.
Looking at my config, I assume I edited the `cover` component:

    payload_not_available: "offline_nope"

I guess that should be "offline", but changing it to any over value prevents it from reporting as `unavailable`.
Bit hacky, and not sure what happens when it's truely unavailble but it seemed to solve my issue.

cmcapone, 2020-07-07:
Thanks for getting back to me with your results.
For what it is worth, I did switch to the "dev" branch and made a tweak to it and have had much better (but not perfect) results.

I added
`client.setKeepAlive(60);`

to both void setup() and the reconnect() functions.

I still occasionally get the instantaneous "unavailable" but much less frequently.  Unfortunately it seems that a couple are still in the multiple minute range (consistently 10-15 minutes).  When this occurs, you cannot command the doors to change state.

Thread 35 (2020-06-22):

Adding Pedestrian doors

davidm2232, 2020-06-22:
It would be nice to have the option to add additional inputs for door sensors for pedestrian doors. Would allow the ability to control auto open/close of doors from
HomeAssistant. I tried it on my own but am not getting the statuses to update.
[GarHage-4_doors.zip](https://github.com/marthoc/GarHAge/files/4816081/GarHage-4_doors.zip)

davidm2232, 2020-06-22:
And the HA configuration.yaml:

binary_sensor:
  - platform: mqtt
    name: "Garage Door 1"
    state_topic: "garage/door/1/status"
    payload_on: "open"
    payload_off: "closed"
    availability_topic: "GarHAge/availability"
    device_class: opening
    qos: 0

  - platform: mqtt
    name: "Garage Door 2"
    state_topic: "garage/door/2/status"
    payload_on: "open"
    payload_off: "closed"
    availability_topic: "GarHAge/availability"
    device_class: opening
    qos: 0

  - platform: mqtt
    name: "Garage Door 3"
    state_topic: "garage/door/3/status"
    payload_on: "open"
    payload_off: "closed"
    availability_topic: "GarHAge/availability"
    device_class: opening
    qos: 0

  - platform: mqtt
    name: "Garage Door 4"
    state_topic: "garage/door/4/status"
    payload_on: "open"
    payload_off: "closed"
    availability_topic: "GarHAge/availability"
    device_class: opening
    qos: 0

rumlak, 2020-06-23:
I am pretty sure this is available in the dev version.

davidm2232, 2020-06-23:
I just looked and it would appear they are. I'll upload them tonight and see if it works.

Thread 36 (2020-06-23):

door status does not match serial monitor

extechy, 2020-06-23:
Have just loaded this onto a wemos d1 mini using 2 x garage doors.  Mostly, the door status does not match serial monitor.  Each time I change the reed switch, a new line from the serial monitor is produced but instead of toggling between closed and open I get maybe three or four lines of 'open' and then a change to 'closed' or vice versa.  Same result for either door.  I have tried a pull-up resistor but no difference.

rumlak, 2020-06-23:
Try using the dev branch.  I have been using it for two years with zero issues.

Thread 38 (2020-11-04):

Gate Status Icons

jy1919, 2020-11-04:
I have used this with HASSIO for my sliding gate opener, and it works pretty well. But i would like to use an open and a close icons for the gate status.
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

what I am getting is this:
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

Is there a way to accomplish this? Thanks for your help.

splasheye, 2021-03-04:
Hi I would like to know the same thing. Is it anyway we could change the icon used in home assistant?

alertedsnake, 2021-03-04:
That's a HomeAssistant issue, use the "customize" feature.

Thread 39 (2021-03-22):

2 Garage Doors 2 Different Devices

556duckvader, 2021-03-22:
I have 2 garage doors and I want to control them with 2 separate devices.  I want 1 for garage door 1 and one for garage door 2.  Is there a way to do this?

556duckvader, 2021-03-22:
I fixed the issue.

Closed 2021-03-22.

Thread 40 (2021-05-27):

2 Reeds for 1 Cover and WS2812 LED

ddinternetagentur, 2021-05-27:
Hello, really a very nice project!

I have been looking for a solution for my garage for a long time.

But unfortunately I am still missing something here, and I wanted to ask whether it is possible to implement this in this project.

I have 2 reed contacts for a garage. Separately for opening and closing

and I would like to control another LED Strip WS2812.

Has someone already implemented that or is there a possibility that someone will help me?

Thread 42 (2024-03-12):

Relays inverted?

vulcanjedi, 2024-03-12:
Finally got all this up to replace my old GarageQTPI installation and had spare nodemcu.
But having this behaviour which I believe was relateively easy fix on GarageQTPI and setting the relay to inverted.  Is that possible here w/ GarHAge?
[](https://community.home-assistant.io/t/garage-door-wired-button-stops-working-when-esp-connected/384915/15)

beanpowered, 2024-06-25:
> Finally got all this up to replace my old GarageQTPI installation and had spare nodemcu. But having this behaviour which I believe was relateively easy fix on GarageQTPI and setting the relay to inverted. Is that possible here w/ GarHAge?
In the "Relay Parameters" you can change from Active High:
https://github.com/marthoc/GarHAge?tab=readme-ov-file#relay-parameters

Relay Parameters
ACTIVE_HIGH_RELAY true

Set to false if using an active-low relay module. Set to true if using an active-high relay module. (Default: true)
