marthoc/GarHAge/(commit log)

2017-08-31 Fix undeclared currentStatusValue variables
    [GarHAge.ino]
2017-09-02 Miscellaneous code updates and cleanup
    In this commit:
    - Added mapping to allow use of NodeMCU port numbers (D0 ... D8) in config.h
    - Changed all config parameter variables to const
    - Implemented DOOR2_ENABLED config parameter throughout code
    - Various variable name cleanups
    - Added variable relayActiveTime to uniformly control the length of time OPEN, CLOSE, and STOP pins are set high to trigger relays before being set low again
    - Commented out mqtt_status_update_interval and lastStatusUpdateTime variables as these are currently not implemented
2017-09-02 Fix typo in reconnect()
    [GarHAge.ino]
2017-09-03 Replaced STOP with STATE
    STOP function with stop pin not useful; instead, respond to STATE payload by publishing current door status (open/closed).
    Created publish_door*_status() functions to check and publish door state throughout code.
    Set currentDoorStatus variables to current door state in setup() to prevent double-publishing of door state on startup.
    [GarHAge.ino, config.h]
2017-09-04 Implement support for NO and NC reed/magnetic switches
    Added variables to config.h and the sketch to support both Normally Open and Normally Closed reed/magnetic switches.
2017-09-04 Added debounce code to publish_doorX_status()
    Debounce code should definitively prevent false status messages from publishing as a result of reed switch bounce when garage door opens or closes; debounceTime currently set to 50ms.
    [GarHAge.ino]
2017-09-05 Increased debounceTime parameter to ensure that only one status update is published
    Dramatically increased the debounceTime (50 to 5000ms) to ensure that only the first switch change is registered as a status change and published.
2017-09-07 Add code to address HASS startup problem
    HASS currently appears to ignore retained messages on the topics it subscribes to when it starts up.
    So, though Door 1 and Door 2 retained status messages may be present on the status topics, HASS ignores these and the door state in HASS may be incorrect (in the case of the cover platform, the state will be "unknown").
    This is an attempt to workaround the problem. HASS can publish a birth message when it starts up. The code added in this commit subscribes to the birth_topic and listens for the payload on that topic. When that message is received, GarHAge will publish current status for Door 1 and Door 2 (if enabled).
    [GarHAge.ino, config.h]
2017-09-08 Fix typo
    Missing two closing "}"
    [GarHAge.ino]
2017-09-08 Call WiFi.mode(WIFI_STA) in setup()
    Explicitly set the wifi mode in setup() to prevent the ESP8266 from operating (by default) as both AP and STA.
    [GarHAge.ino]
2017-09-08 Move sketch into subdirectory
    Move GarHAge.ino and config.h into the GarHAge subdirectory to prevent an Arduino IDE error on sketch open (IDE expects the sketch to be in a folder of the same name) when downloading a GitHub release (which numbers the top level folder with the release version).
    [GarHAge.ino, config.h]
2017-09-08 Updated sketch and config header
    Updated sketch and config header to match current project name
2017-09-10 Added 10s delay before birth message response
    Response after birth message still does not reliably result in correct status after HASS startup. Added 10s delay before response.
    [GarHAge.ino]
2017-09-11 Revert "Added 10s delay before birth message response"
    This reverts commit 0f5dcd10d4795c8bdd11e9fa51a080ce6a57fba4.
    [GarHAge.ino]
2017-09-11 Remove HASS workaround parameters and code
    Removed in favour of using an automation on startup as a better workaround.
    [GarHAge.ino, config.h]
2017-09-27 Add code to support active-low relays (#3)
    * Add code to support active-low relay modules
    Added config.h parameter and modified triggerRelay() and setup() functions to support active-low relay modules (i.e. SainSmart)
2017-10-04 Update README.md for active-low relay support
